freetronics/GSMGPSShield/README.markdown

GSMGPSShield 

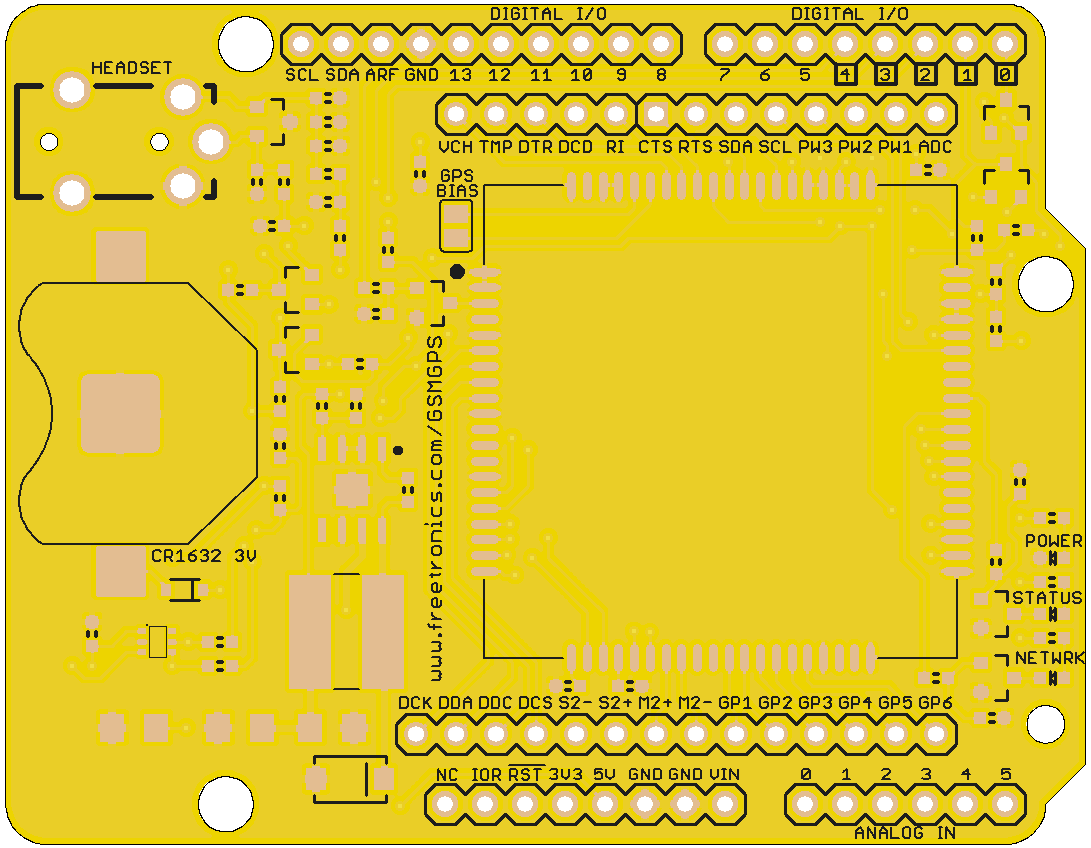
[picture p1: GSMGPSShield-preview.png]
