freetronics/GSMGPSShield/GSMGPSShield-schematic.pdf

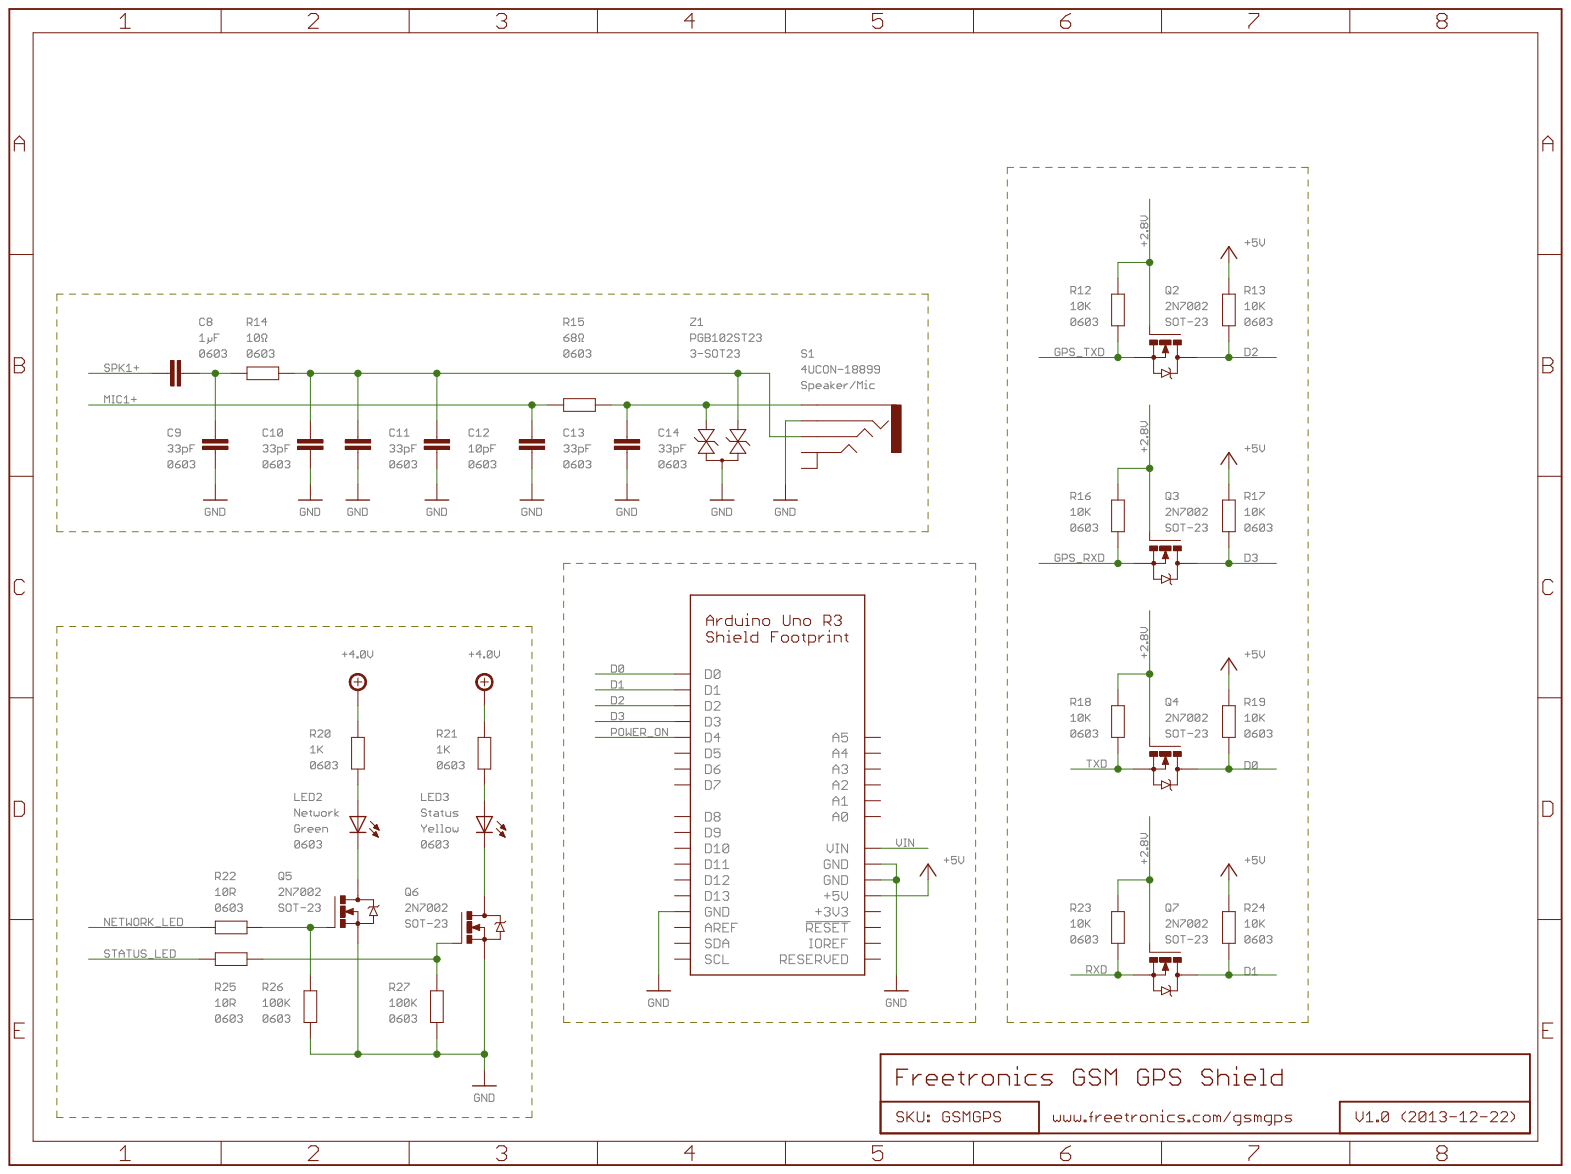
[picture p2: page 1]

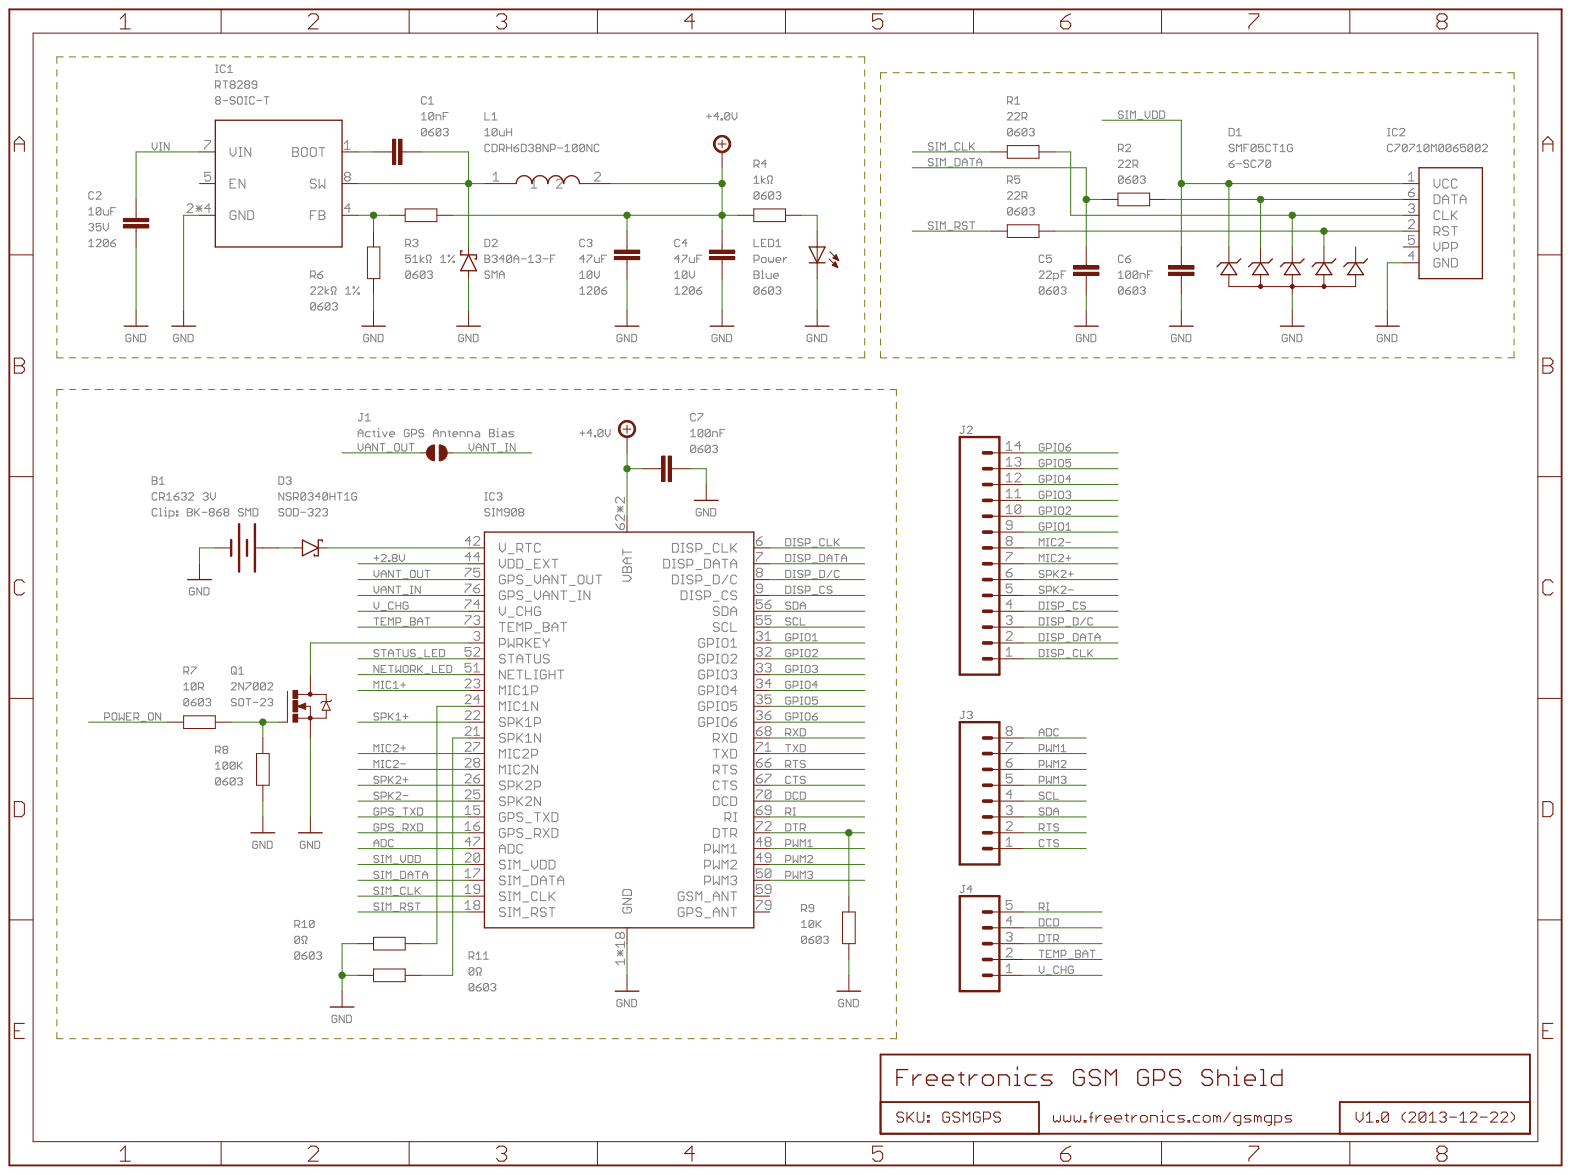
[picture p3: page 2]
