freetronics/GSMGPSShield/GSMGPSShield.brd

## EAGLE design GSMGPSShield.brd (2014-01-23)

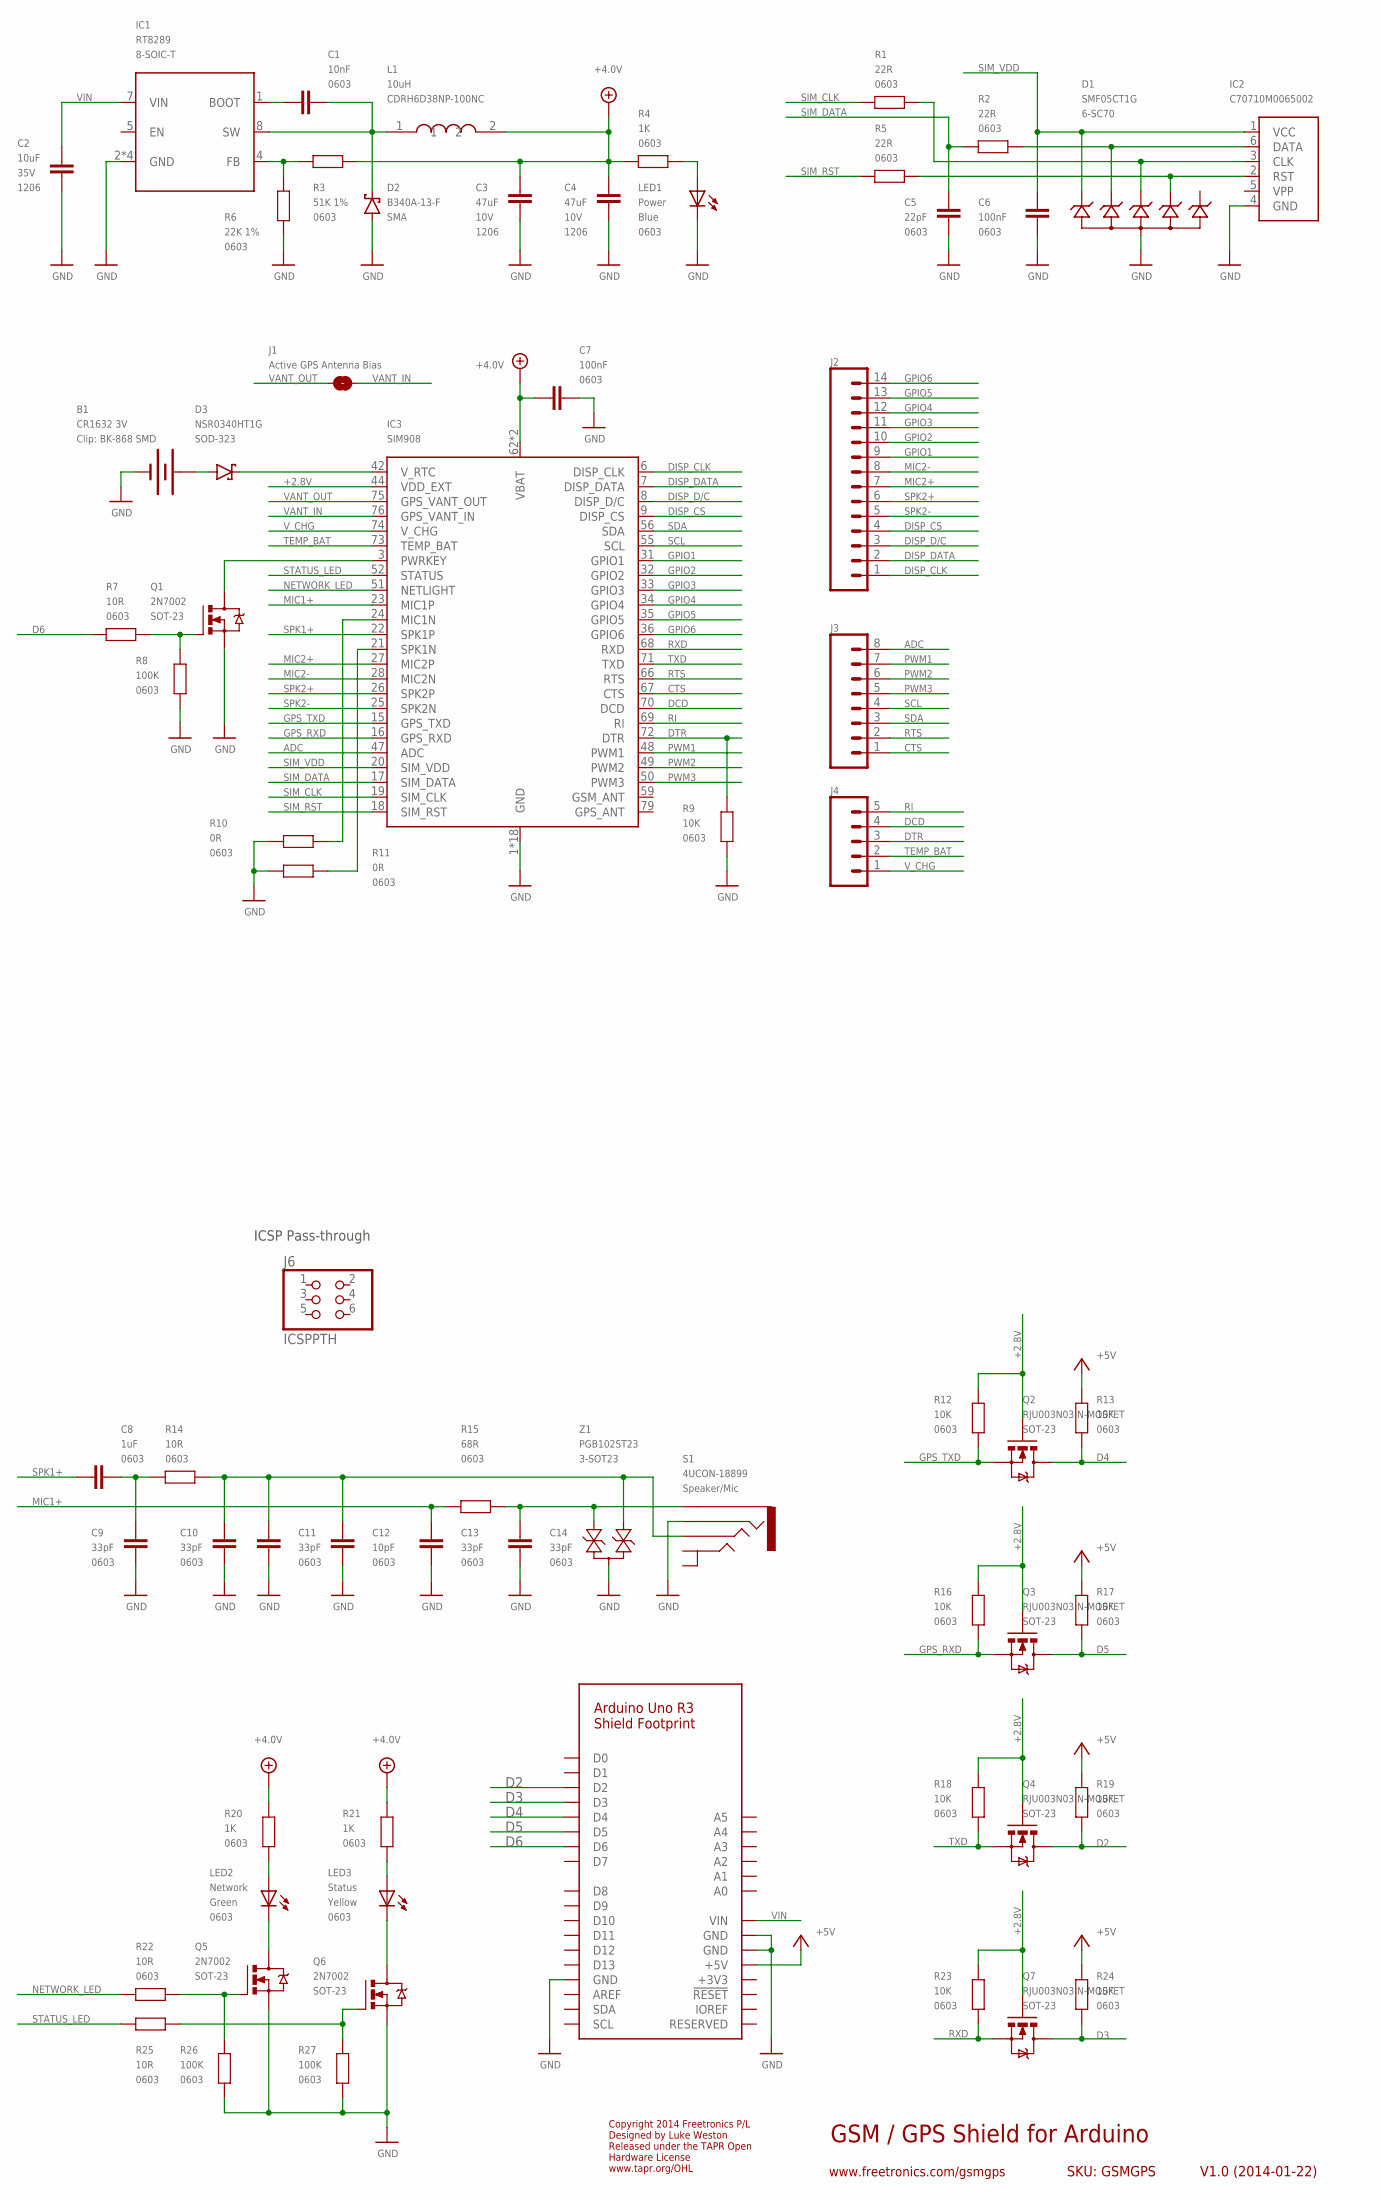
[picture p4: schematic GSMGPSShield.sch]

Parts:
B1: CR1632 3V; BATCON_16MM
C1: 10nF; 0603
C2: 10uF; C1206; VOLTAGE 35V
C3, C4: 47uF; C1206; VOLTAGE 10V
C5: 22pF; 0603
C6, C7: 100nF; 0603
C8: 1uF; 0603
C9, C10, C11, C13, C14: 33pF; 0603
C12: 10pF; 0603
D1: SMF05CT1G; SC70-6
D2: B340A-13-F; SMA
D3: NSR0340HT1G; SOD-323
IC1: RT8289; SO08T
IC2: C70710M0065002
IC3: SIM908
J1: Active GPS Antenna Bias; SJ
J2: M14; 1X14
J3: M08STD; 1X08
J4: M05PTH; 1X05
J5: ARDUINO-SHIELD_R3_NOISP
J6: ICSPPTH; 2X03PTH
L1: 10uH; CDRH
LED1: Power; LED-0603
LED2: Network; LED-0603
LED3: Status; LED-0603
Q1, Q5, Q6: 2N7002; SOT23-3
Q2, Q3, Q4, Q7: RJU003N03 N-MOSFET; SOT32-3
R1, R2, R5: 22R; 0603
R3: 51K 1%; 0603
R4, R20, R21: 1K; 0603
R6: 22K 1%; 0603
R7, R14, R22, R25: 10R; 0603
R8, R26, R27: 100K; 0603
R9, R12, R13, R16, R17, R18, R19, R23, R24: 10K; 0603
R10, R11: 0R; 0603
R15: 68R; 0603
S1: 4UCON-18899
Z1: PGB102ST23; SOT23-3

Connections:
+2.8V: IC3.44 (VDD_EXT), Q2.1 (G), Q3.1 (G), Q4.1 (G), Q7.1 (G), R12.1, R16.1, R18.1, R23.1
+3V3: J5.3V3 (+3V3)
+4.0V: C3.1, C4.1, C7.2, IC3.62 (VBAT), IC3.63 (VBAT), L1.2, R3.1, R4.1, R20.1, R21.1
+5V: J5.+5V, R13.1, R17.1, R19.1, R24.1
ADC: IC3.47 (ADC), J3.8
CTS: IC3.67 (CTS), J3.1
D2: J5.D2, Q4.3 (D), R19.2
D3: J5.D3, Q7.3 (D), R24.2
D4: J5.D4, Q2.3 (D), R13.2
D5: J5.D5, Q3.3 (D), R17.2
D6: J5.D6, R7.2
DCD: IC3.70 (DCD), J4.4
DISP_CLK: IC3.6 (DISP_CLK), J2.1
DISP_CS: IC3.9 (DISP_CS), J2.4
DISP_D/C: IC3.8 (DISP_D/C), J2.3
DISP_DATA: IC3.7 (DISP_DATA), J2.2
DTR: IC3.72 (DTR), J4.3, R9.1
GND: B1.GND (-), C2.2, C3.2, C4.2, C5.1, C6.1, C7.1, C9.1, C10.1, C11.1, C12.1, C13.1, C14.1, D1.2 (A2), D2.A, IC1.2 (GND), IC1.3 (GND), IC1.6 (GND), IC1.PAD (GND), IC2.4 (GND), IC3.1 (GND), IC3.2 (GND), IC3.5 (GND), IC3.10 (GND), IC3.14 (GND), IC3.37 (GND), IC3.40 (GND), IC3.41 (GND), IC3.43 (GND), IC3.57 (GND), IC3.58 (GND), IC3.60 (GND), IC3.61 (GND), IC3.64 (GND), IC3.65 (GND), IC3.77 (GND), IC3.78 (GND), IC3.80 (GND), J5.GND, J5.GND@0 (GND), J5.GND@1 (GND), LED1.C, Q1.2 (S), Q5.2 (S), Q6.2 (S), R6.1, R8.1, R9.2, R10.2, R11.2, R26.1, R27.1, S1.4, Z1.3
GPIO1: IC3.31 (GPIO1), J2.9
GPIO2: IC3.32 (GPIO2), J2.10
GPIO3: IC3.33 (GPIO3), J2.11
GPIO4: IC3.34 (GPIO4), J2.12
GPIO5: IC3.35 (GPIO5), J2.13
GPIO6: IC3.36 (GPIO6), J2.14
GPS_RXD: IC3.16 (GPS_RXD), Q3.2 (S), R16.2
GPS_TXD: IC3.15 (GPS_TXD), Q2.2 (S), R12.2
MIC1+: C13.2, IC3.23 (MIC1P), R15.1
MIC2+: IC3.27 (MIC2P), J2.7
MIC2-: IC3.28 (MIC2N), J2.8
unnamed: LED1.A, R4.2
unnamed: LED2.C, Q5.3 (D)
unnamed: LED3.C, Q6.3 (D)
unnamed: Q5.1 (G), R22.1, R26.2
unnamed: Q6.1 (G), R25.1, R27.2
unnamed: D3.K, IC3.42 (V_RTC)
unnamed: IC3.3 (PWRKEY), Q1.3 (D)
unnamed: B1.PWR@1 (+), D3.A
unnamed: IC3.21 (SPK1N), R11.1
unnamed: IC3.24 (MIC1N), R10.1
unnamed: D1.5 (K5), IC2.2 (RST), R5.1
unnamed: D1.4 (K4), IC2.3 (CLK), R1.1
unnamed: D1.3 (K3), IC2.6 (DATA), R2.1
unnamed: C14.2, R15.2, S1.1, Z1.2
unnamed: C10.2, C11.2, C12.2, R14.2, S1.3, Z1.1
unnamed: C8.1, C9.2, R14.1
unnamed: Q1.1 (G), R7.1, R8.2
unnamed: LED3.A, R21.2
unnamed: LED2.A, R20.2
unnamed: C1.1, D2.K, IC1.8 (SW), L1.1
unnamed: IC1.4 (FB), R3.2, R6.2
unnamed: C1.2, IC1.1 (BOOT)
NETWORK_LED: IC3.51 (NETLIGHT), R22.2
PWM1: IC3.48 (PWM1), J3.7
PWM2: IC3.49 (PWM2), J3.6
PWM3: IC3.50 (PWM3), J3.5
RI: IC3.69 (RI), J4.5
RTS: IC3.66 (RTS), J3.2
RXD: IC3.68 (RXD), Q7.2 (S), R23.2
SCL: IC3.55 (SCL), J3.4
SDA: IC3.56 (SDA), J3.3
SIM_CLK: IC3.19 (SIM_CLK), R1.2
SIM_DATA: C5.2, IC3.17 (SIM_DATA), R2.2
SIM_RST: IC3.18 (SIM_RST), R5.2
SIM_VDD: C6.2, D1.1 (K1), IC2.1 (VCC), IC3.20 (SIM_VDD)
SPK1+: C8.2, IC3.22 (SPK1P)
SPK2+: IC3.26 (SPK2P), J2.6
SPK2-: IC3.25 (SPK2N), J2.5
STATUS_LED: IC3.52 (STATUS), R25.2
TEMP_BAT: IC3.73 (TEMP_BAT), J4.2
TXD: IC3.71 (TXD), Q4.2 (S), R18.2
VANT_IN: IC3.76 (GPS_VANT_IN), J1.2
VANT_OUT: IC3.75 (GPS_VANT_OUT), J1.1
VIN: C2.1, IC1.7 (VIN), J5.VIN
V_CHG: IC3.74 (V_CHG), J4.1

Notes on the sheet:
GSM / GPS Shield for Arduino
V1.0 (2014-01-22)
www.freetronics.com/gsmgps
SKU: GSMGPS
Copyright 2014 Freetronics P/L Designed by Luke Weston Released under the TAPR Open Hardware License www.tapr.org/OHL
ICSP Pass-through

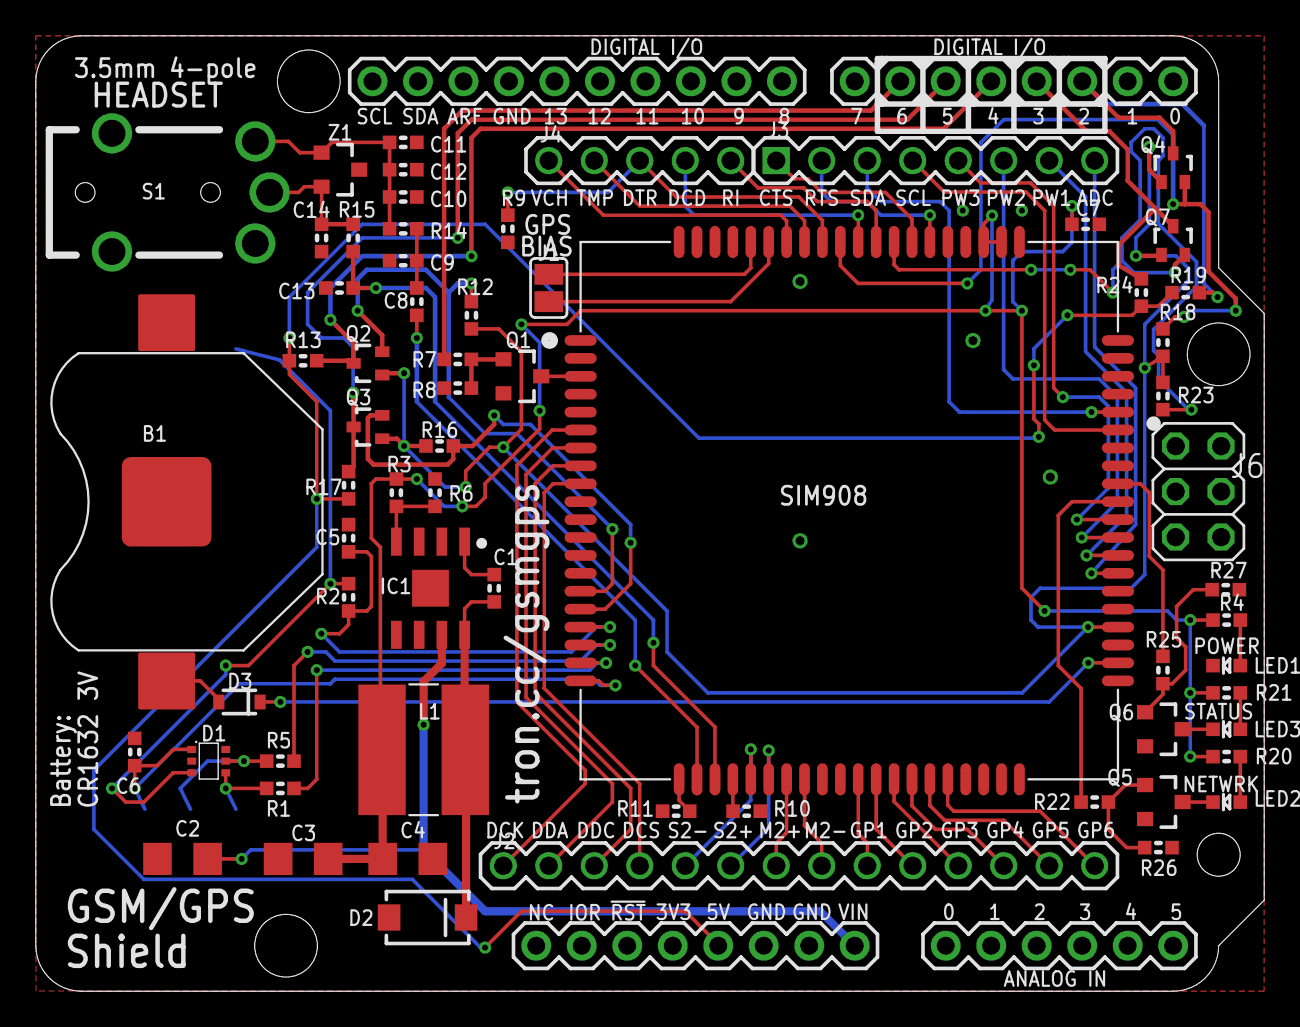
[picture p5: board GSMGPSShield.brd from above]

Board: 2 copper layers, 68.6 x 53.3 mm, 67 parts (1 on the bottom side), 73 nets.
