freetronics/GSMGPSShield/(commit log)

2013-12-05 Changed all fonts to vector Increased VIA size Added version number and license to overlay Added chip orientation markers in tdocu layer Repositioned designators
    [GSMshield.brd, GSMshield.sch]
2013-12-13 Renamed files to convert to SIM908
    [GSMGPSShield.brd, GSMGPSShield.sch]
2013-12-27 changed to SIM908 module, first finished draft
    [GSMGPSShield.brd, GSMGPSShield.sch]
2014-01-22 Replaced Greek characters with Latin equivalents
    [GSMGPSShield.sch]
2014-01-22 Relocated project close to 0,0 origin. Couldn't get it quite right
    [GSMGPSShield.brd]
2014-01-23 Replaced level shifter FETs with RJU003N03
    [GSMGPSShield.sch]
2014-01-23 Fixed footprint for headphone socket Changed pin assignments to D2-D6 to clear D0/D1 UART for programming Added ICSP header for pass-through Replaced level shifter FETs with RJU003N03 Added orientati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
    [GSMGPSShield.brd, GSMGPSShield.sch]
