freetronics/GSMGPSShield/(notices)

Notices in the files:
GSMGPSShield.brd:
Copyright 2014 Freetronics Pty Ltd
Released under the terms of the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
